vrifmus/m13/gallery.md

[⬅️ Home](README.md)

# Gallery

<p>
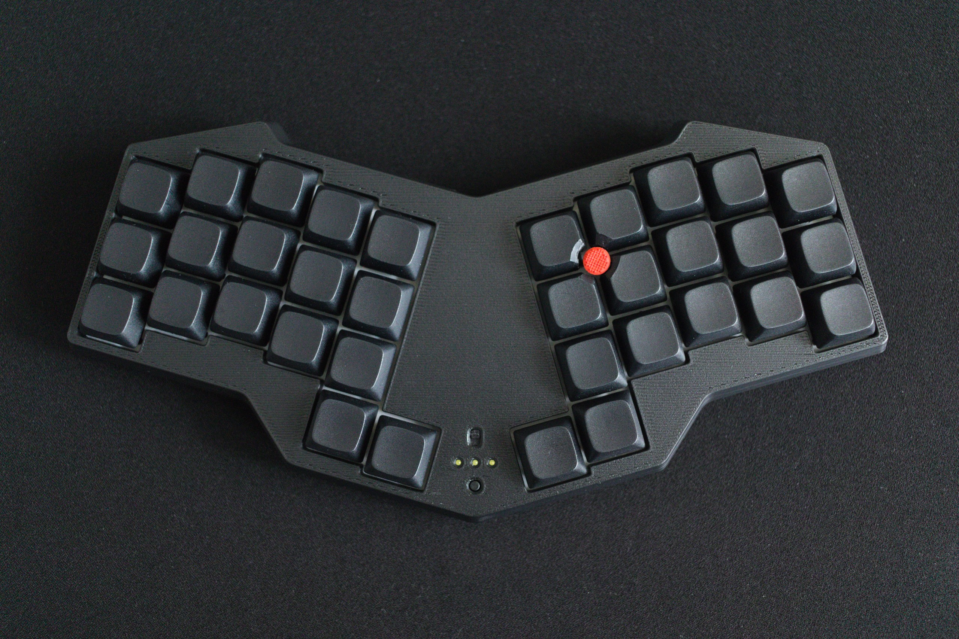
[picture p3: images/gallery/top.jpg]
    
</p>
<p>
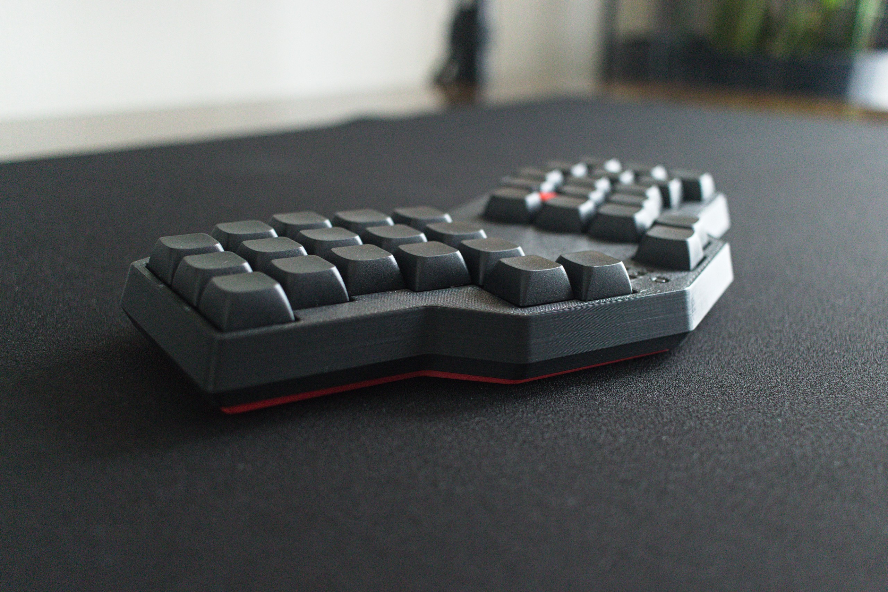
[picture p4: images/gallery/top-left.jpg]
    
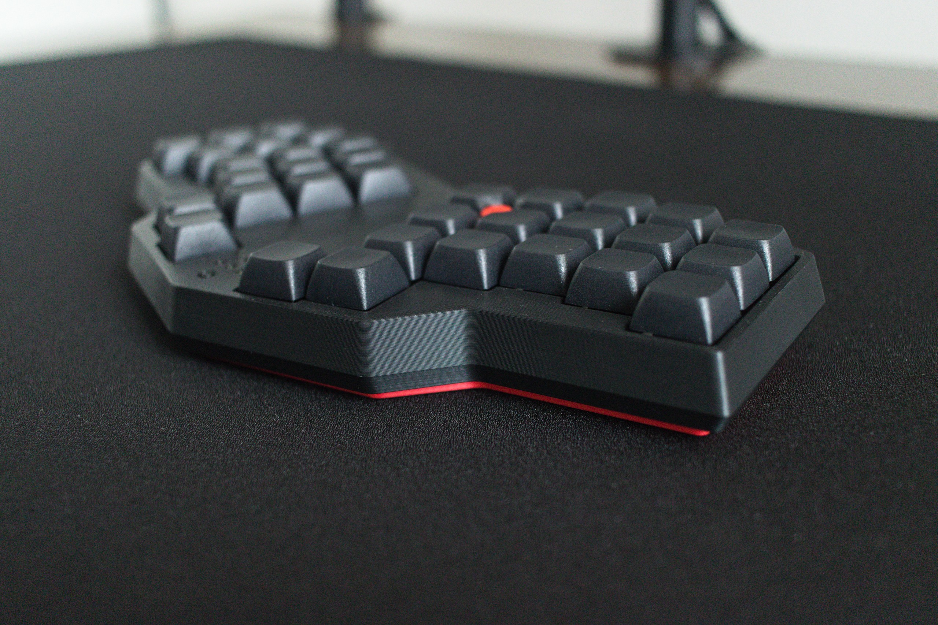
[picture p5: images/gallery/top-right.jpg]
    
</p>
<p>
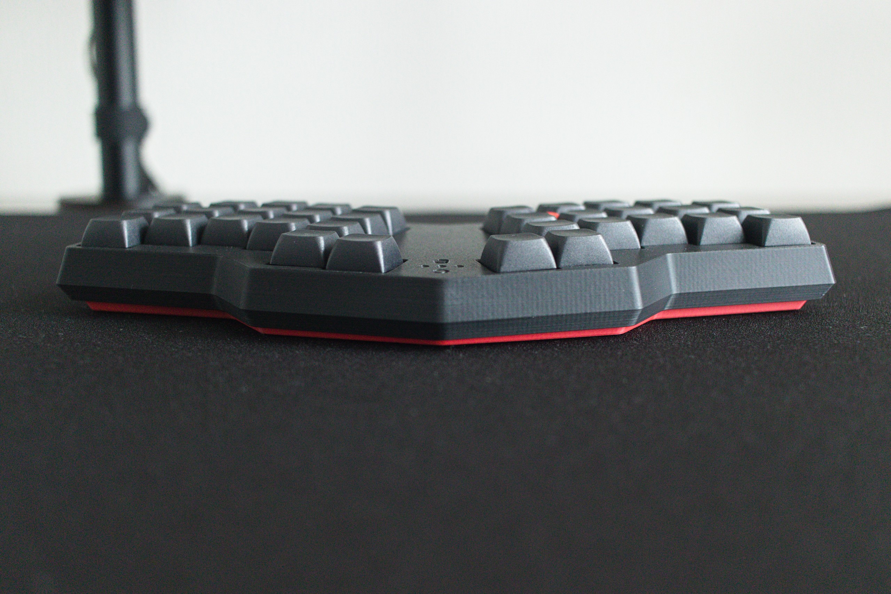
[picture p6: images/gallery/front.jpg]
    
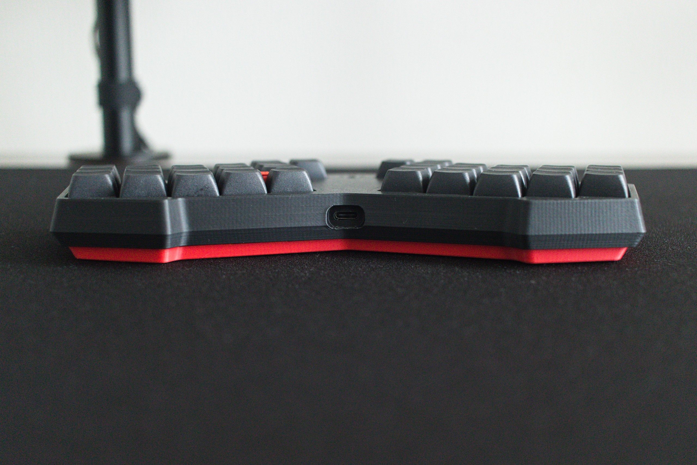
[picture p7: images/gallery/back.jpg]
    
</p>
<p>
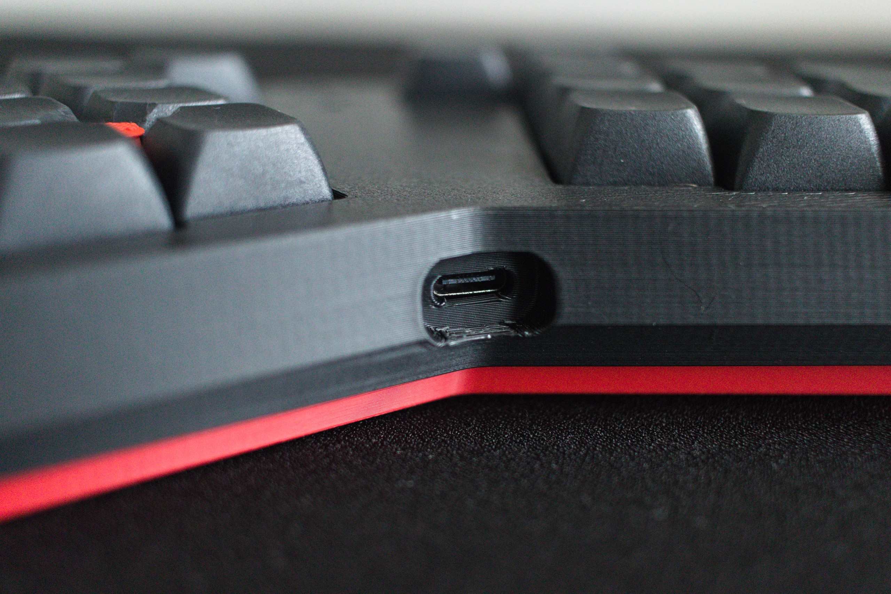
[picture p8: images/gallery/port.jpg]
    
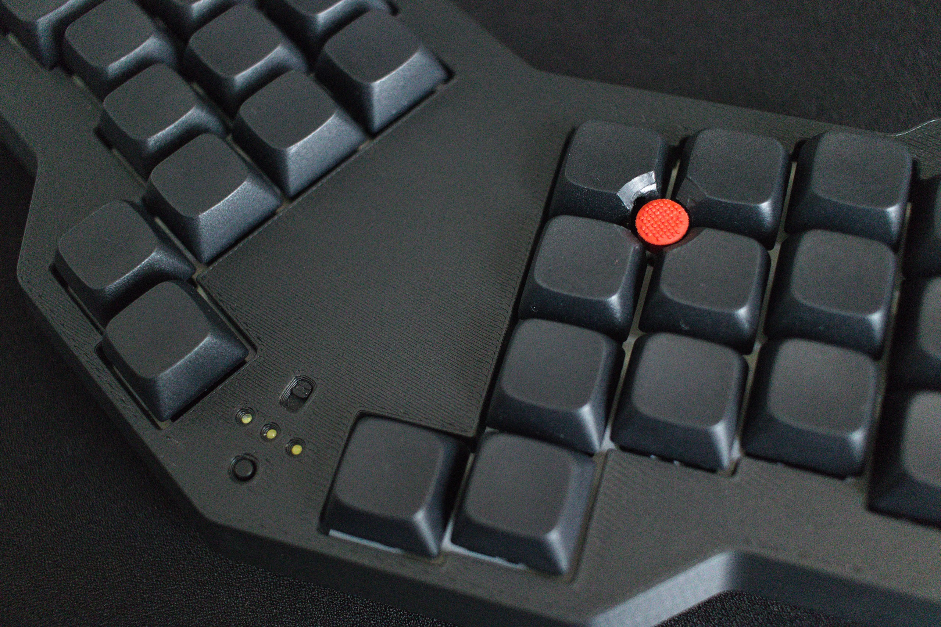
[picture p9: images/gallery/top-center.jpg]
    
</p>
<p>
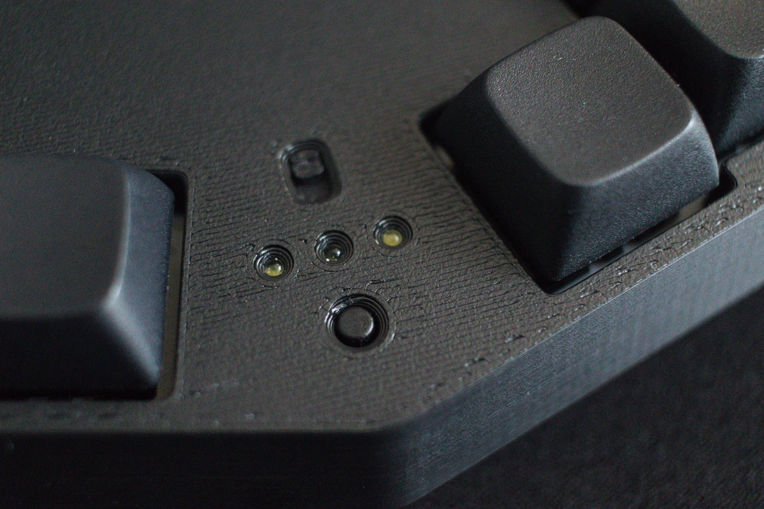
[picture p10: images/gallery/controls.jpg]
    
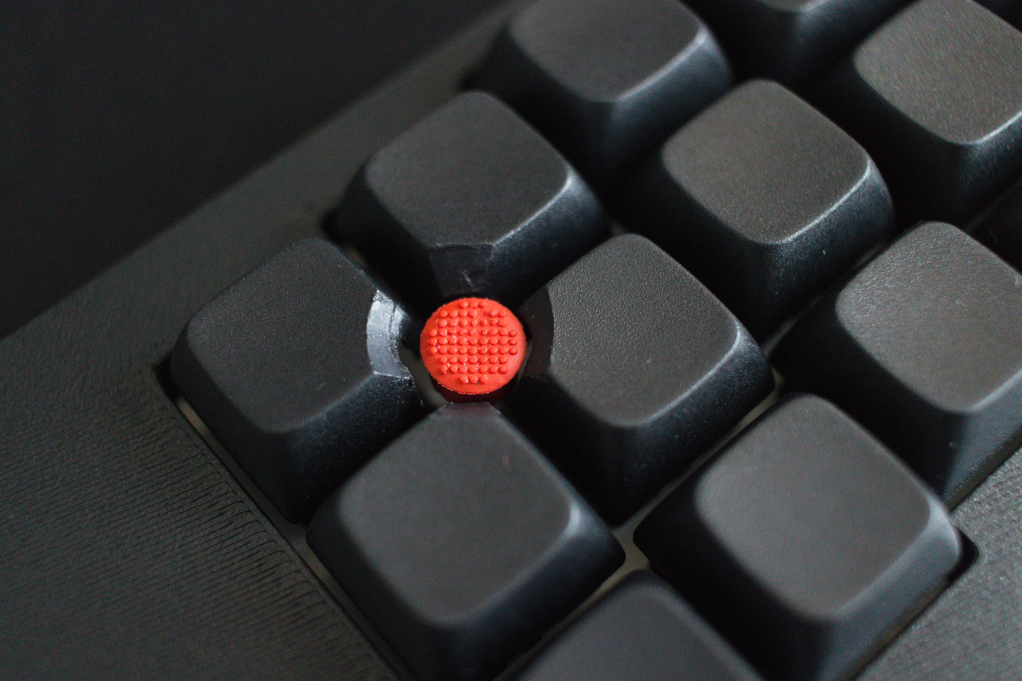
[picture p11: images/gallery/top-point.jpg]
    
</p>
<p>
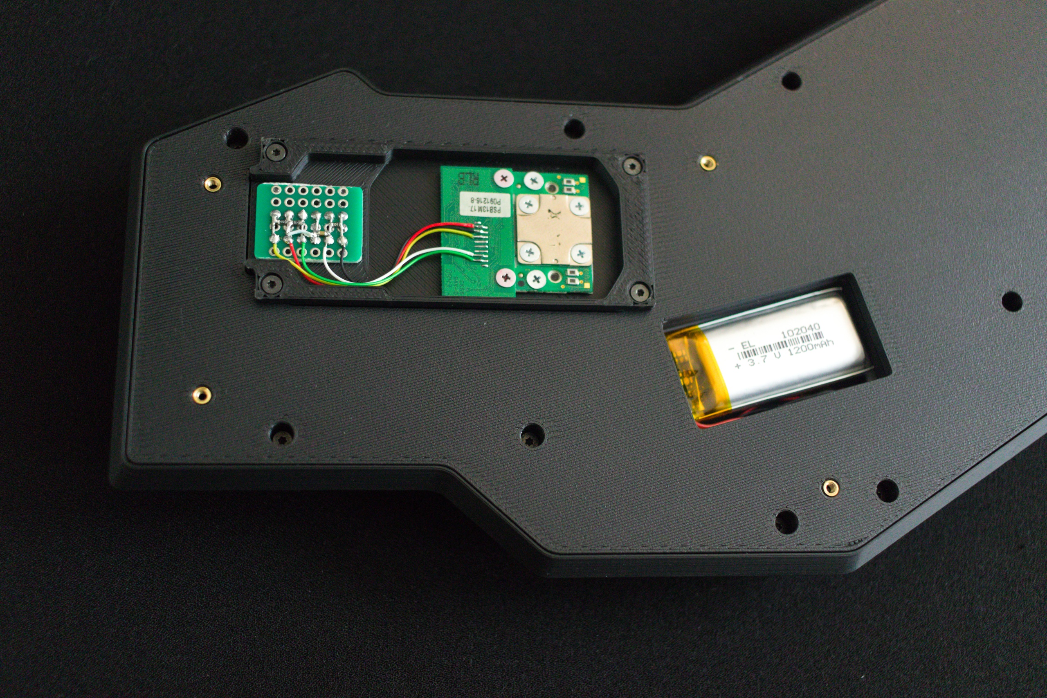
[picture p12: images/gallery/undercover.jpg]
    
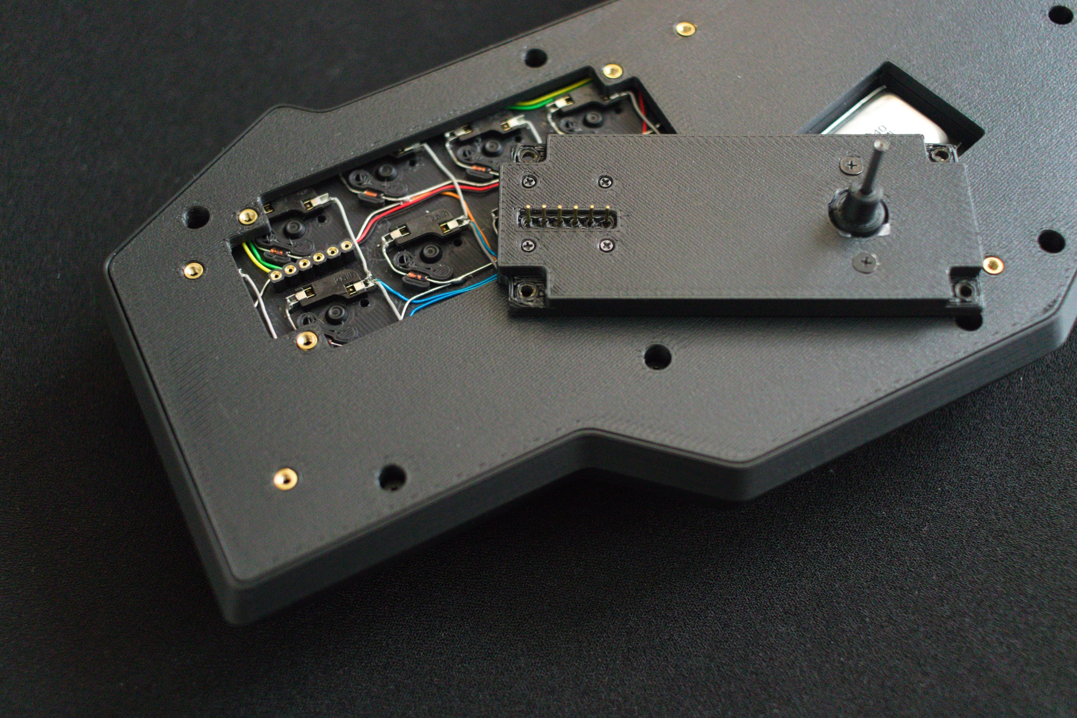
[picture p13: images/gallery/module.jpg]
    
</p>
<p>
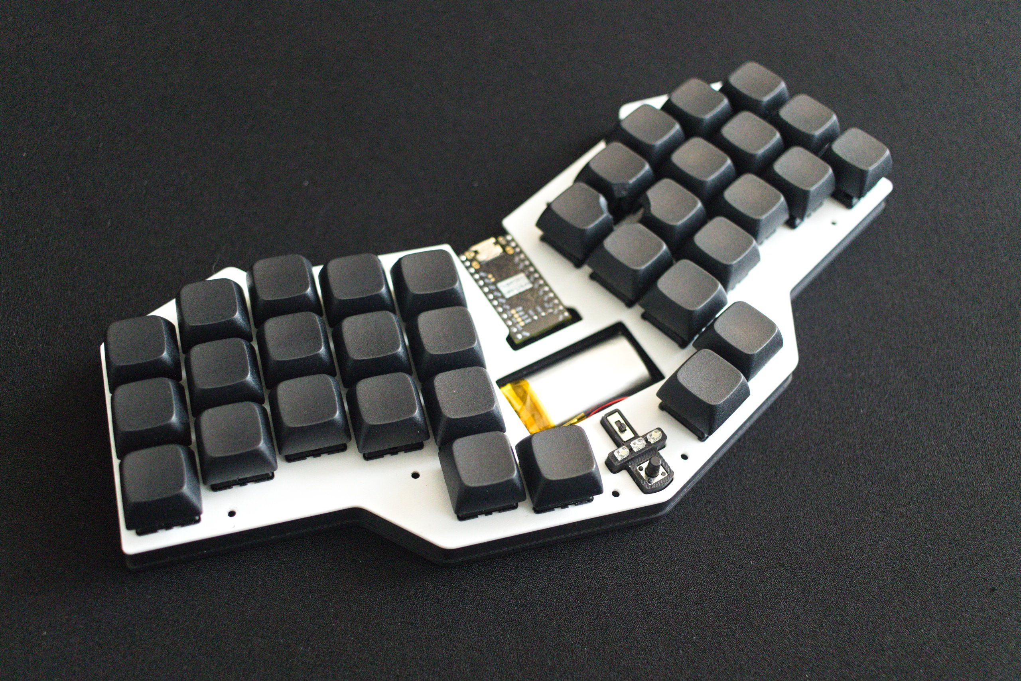
[picture p14: images/gallery/topless.jpg]
    
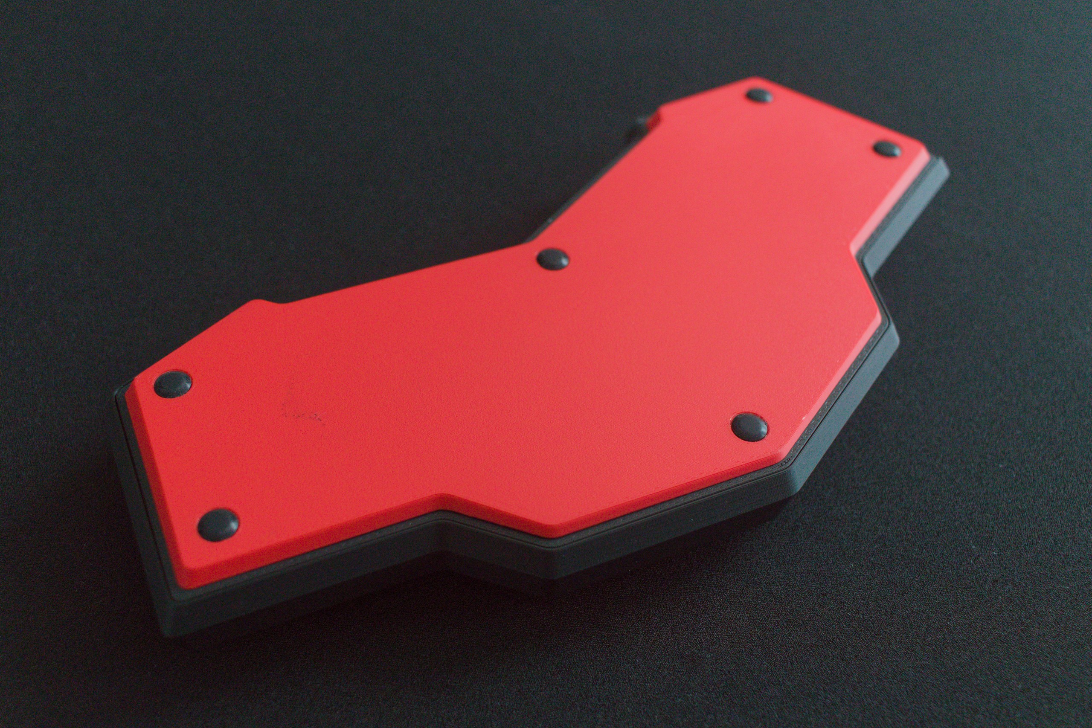
[picture p15: images/gallery/bot-left.jpg]
    
</p>
<p>
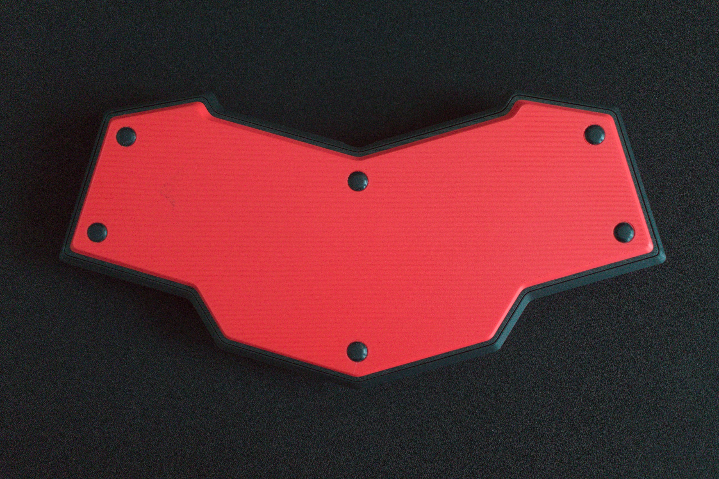
[picture p16: images/gallery/bot.jpg]
    
</p>

**Filament:** Matte PLA \
**Switches:** MX2A Silent Red \
**Keycaps:** NP Blanks

[⬅️ Home](README.md)
