vrifmus/m13/STEP/tools/keycaps/base.step

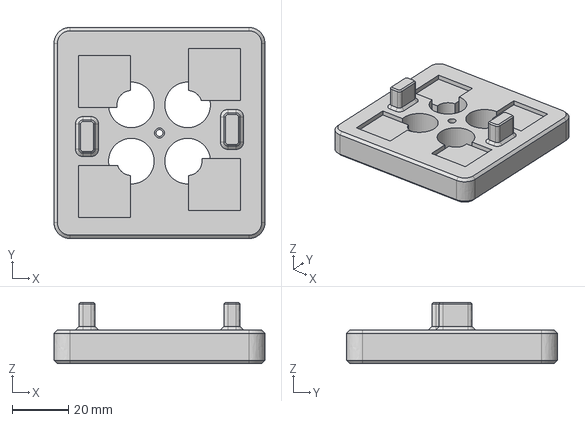
[picture p17: CAD file, 2026-05-20]
STEP/tools/keycaps/base.step
75.0 x 75.0 x 21.8 mm
