vrifmus/m13/STEP/tools/wiring/spacer.step

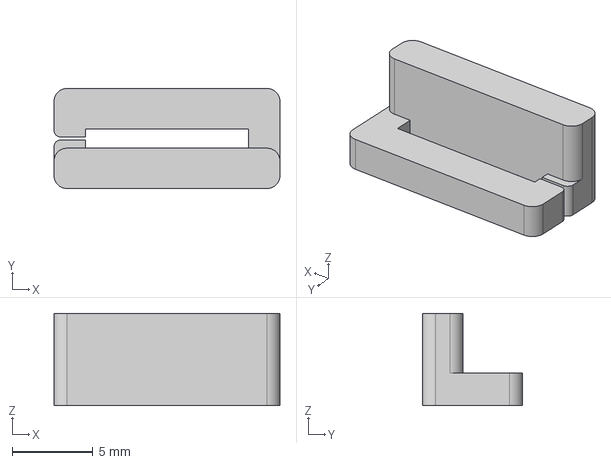
[picture p18: CAD file, 2026-05-20]
STEP/tools/wiring/spacer.step
14.0 x 6.20 x 5.70 mm
