vrifmus/m13/STL/top.stl

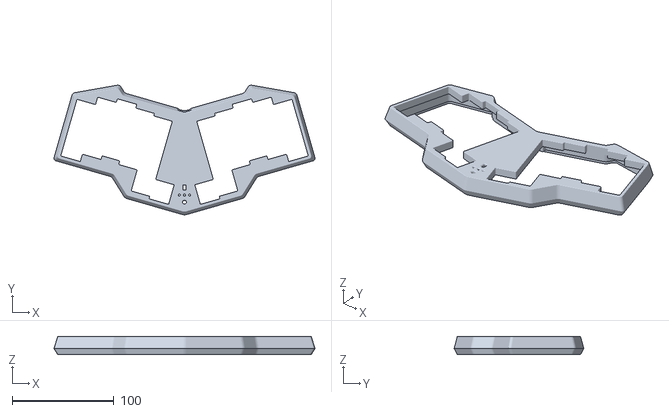
[picture p19: CAD file, 2026-05-20]
STL/top.stl
257.1 x 127.7 x 18.0
