vrifmus/m13/STL/trackpoint/bracket.stl

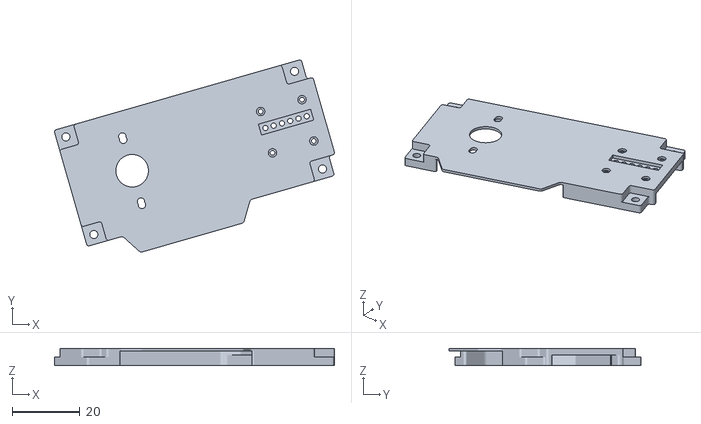
[picture p20: CAD file, 2026-05-20]
STL/trackpoint/bracket.stl
82.6 x 56.7 x 5.10
