vrifmus/m13/STEP/tools/keycaps/cover.step

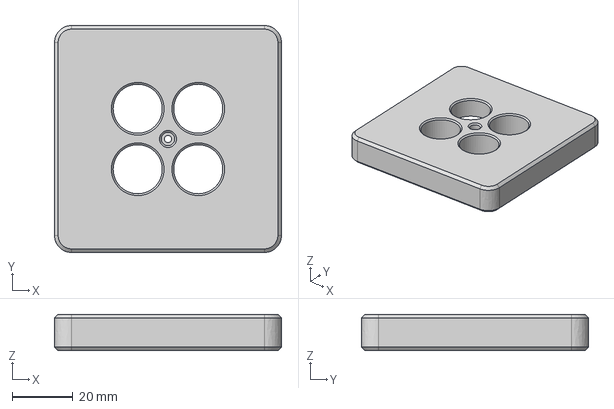
[picture p21: CAD file, 2026-05-20]
STEP/tools/keycaps/cover.step
75.0 x 75.0 x 12.0 mm
