vrifmus/m13/STEP/trackpoint/stem_r61.step

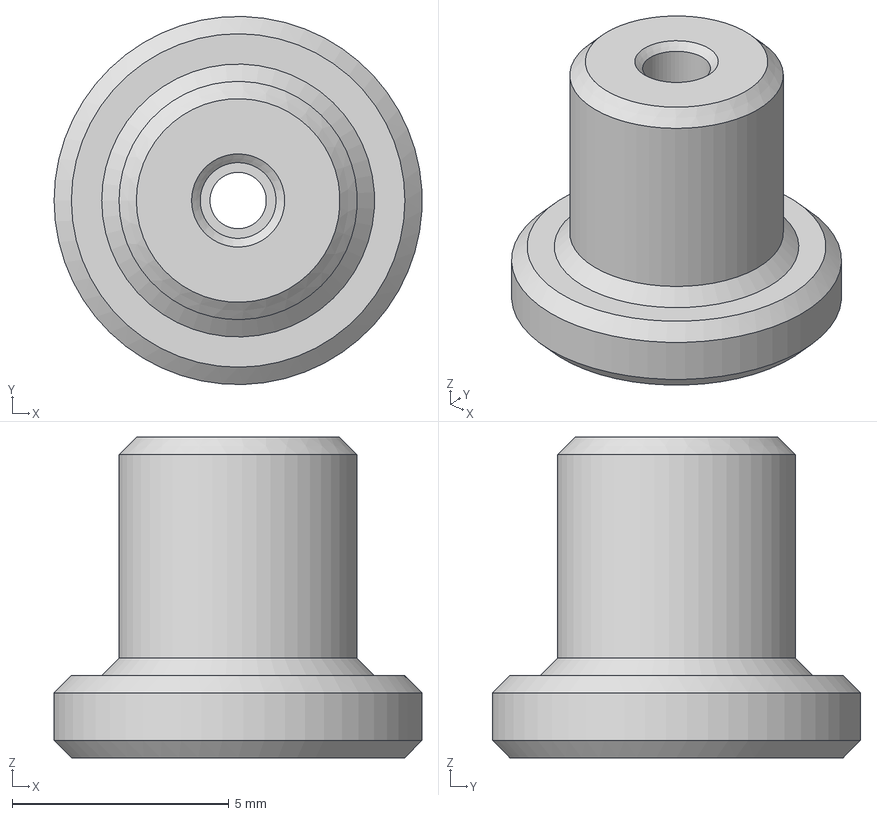
[picture p22: CAD file, 2026-05-20]
STEP/trackpoint/stem_r61.step
8.49 x 8.50 x 7.40 mm
