vrifmus/m13/STL/board.stl

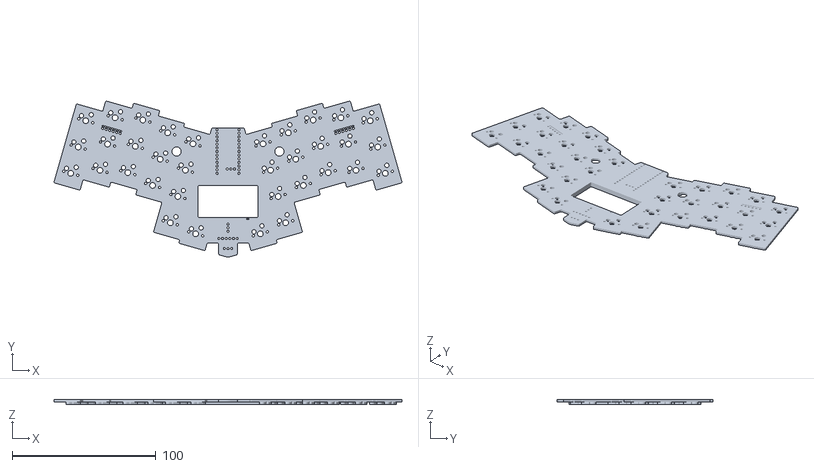
[picture p23: CAD file, 2026-05-20]
STL/board.stl
242.3 x 108.5 x 3.40
