vrifmus/m13/STL/trackpoint/adapter_np.stl

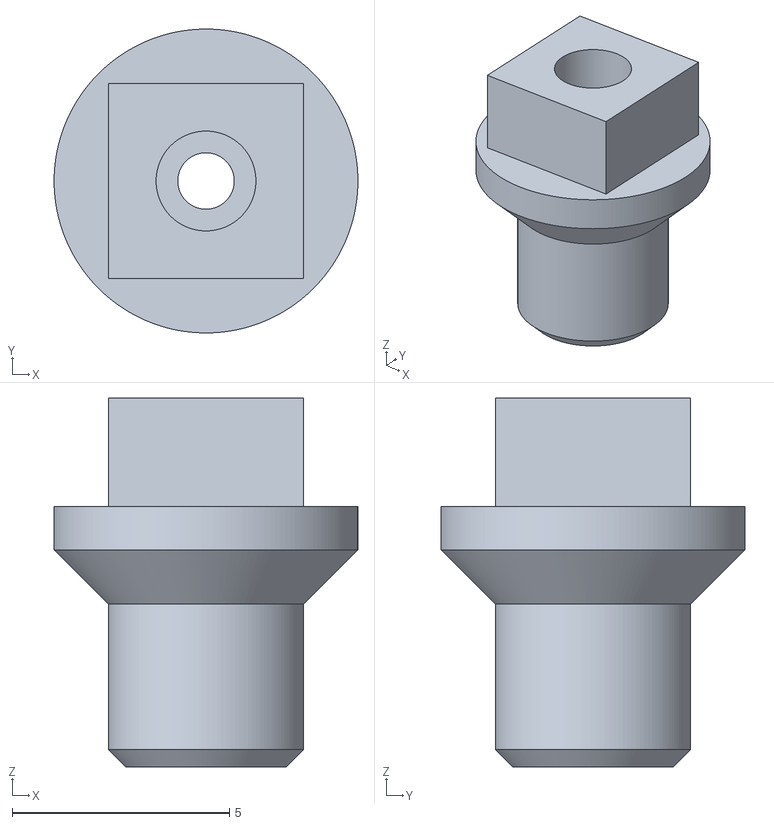
[picture p24: CAD file, 2026-05-20]
STL/trackpoint/adapter_np.stl
7.00 x 7.00 x 8.50
