vrifmus/m13/STEP/tools/keycaps/stencil.step

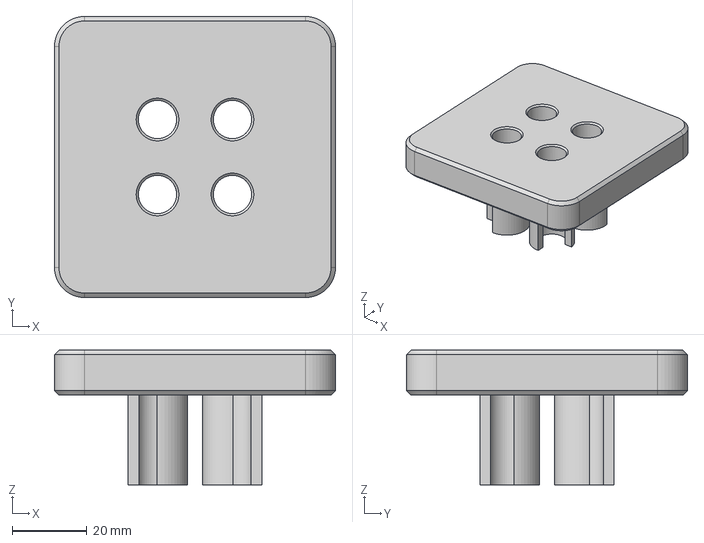
[picture p25: CAD file, 2026-05-20]
STEP/tools/keycaps/stencil.step
75.0 x 75.0 x 36.0 mm
