vrifmus/m13/STL/power.stl

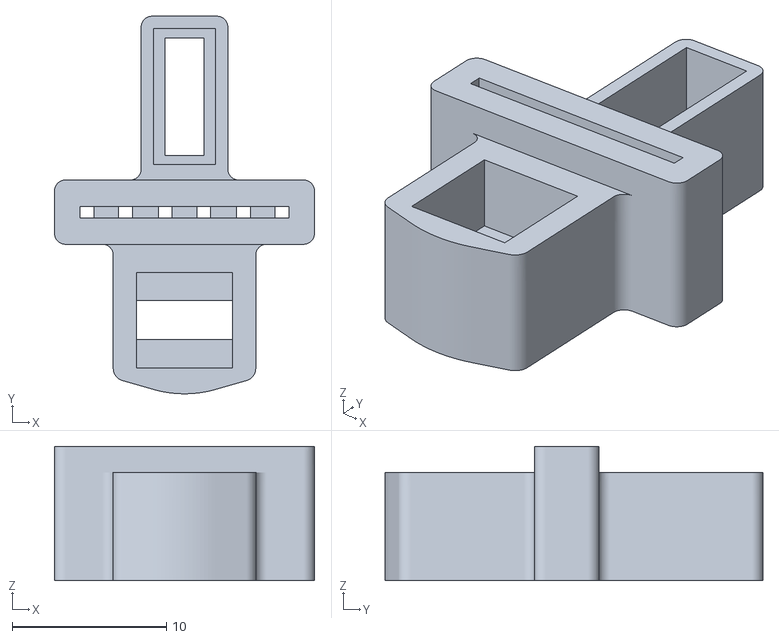
[picture p26: CAD file, 2026-05-20]
STL/power.stl
16.9 x 24.5 x 8.70
