vrifmus/m13/STL/cover.stl

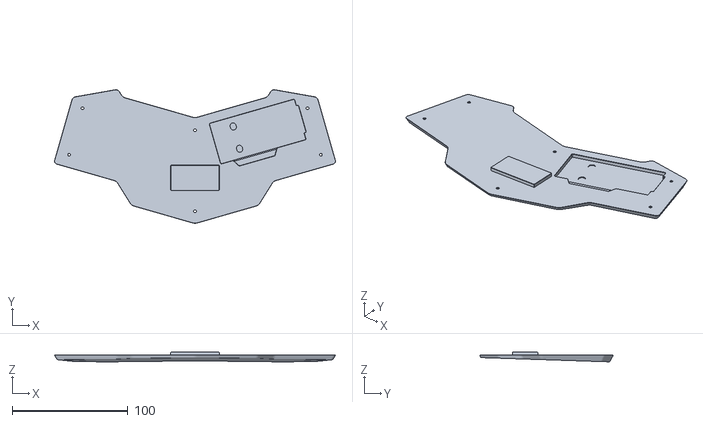
[picture p27: CAD file, 2026-05-20]
STL/cover.stl
243.0 x 115.5 x 8.39
