vrifmus/m13/STL/bot.stl

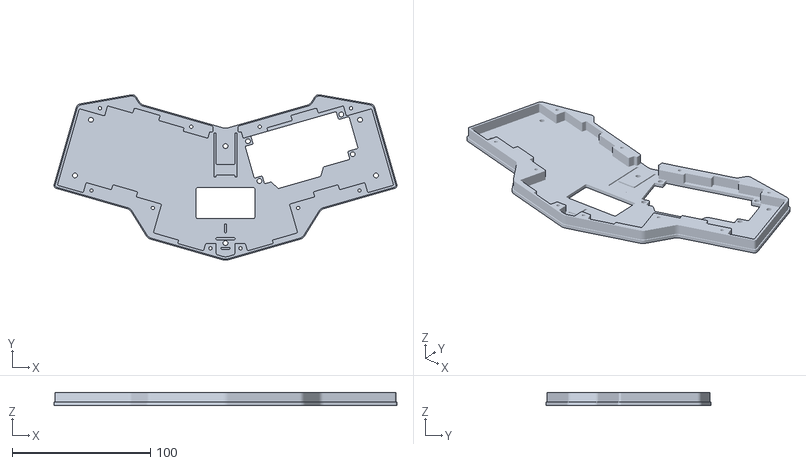
[picture p28: CAD file, 2026-05-20]
STL/bot.stl
248.0 x 119.6 x 9.40
