vrifmus/m13/STL/slider.stl

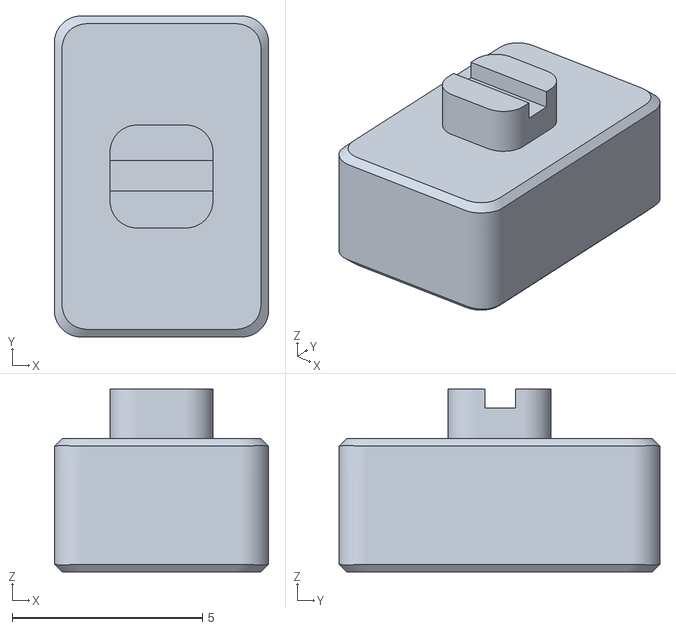
[picture p29: CAD file, 2026-05-20]
STL/slider.stl
5.63 x 8.43 x 4.80
