vrifmus/m13/STL/plate.stl

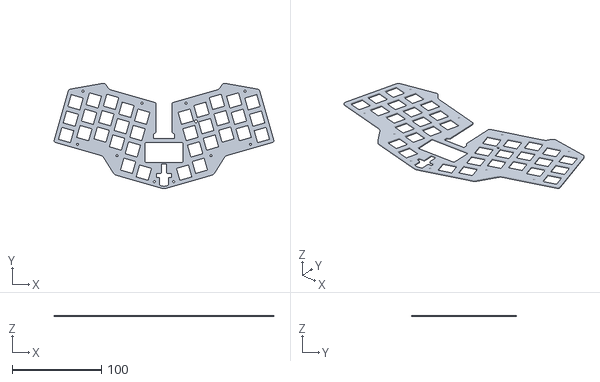
[picture p30: CAD file, 2026-05-20]
STL/plate.stl
246.3 x 117.9 x 1.50
