vrifmus/m13/(list of files, cad)

Other CAD files:
STEP/trackpoint/adapter_dsa.step
STL/trackpoint/adapter_xda.stl
STL/trackpoint/adapter_xda-v2.stl
STL/tools/keycaps/base.stl
STL/tools/keycaps/cover.stl
STL/tools/keycaps/stencil.stl
STL/tools/wiring/spacer.stl
STL/trackpoint/adapter_dsa.stl
STL/trackpoint/stem_r61.stl
